TimothyWright95/Embedded-Senior-Project/Communication protocol.docx

Basestation to RCU

0 = ERROR

1 = Reached side move down

2 = Ready for Brushes

RCU to Basestation

0 = ERROR

1 = Finished moving

2 = Battery LOW

3 = End of array moved up
