TimothyWright95/Embedded-Senior-Project/PowerPoint.pptx

Modular Solar Panel Cleaner

By Timothy Wright

## Slide 2

The Problem

- Solar panels often get dirty, especially in rural farming areas
- Studies from the National Renewable Energy Laboratories show that dirty solar panels can reduce efficiency by up to 25%
- Solar panels are sometimes installed in hard to reach areas therefore it is difficult or even impossible to clean

## Slide 3

My Solution

- Modular Solar Array Cleaner or MSAC
- Autonomous robot that is installed alongside the solar array
- Robot will clean entire array according to a preset schedule using either a water or waterless system
- Modularity allows it to be fitted to almost any size solar array and is only limited by the size of the on board battery
- Also allows remote control of Robot to spot clean

## Slide 4

What currently exists

- Most solar panel cleaners are designed for commercial ground based solar arrays
- There are some solar array cleaners that are meant for home solar array such as the RAYBOT by ECOVACS and Scrobby by Stefan Hamminga
- RAYBOT- very slow and waterless only, also not currently available to buy
- Scrobby – cleans using water collected from rainfall therefore only cleans 3-4 times a year

## Slide 5

Why is MSAC Unique

- Water or waterless cleaning
- Remote control cleaning
- Battery powered with built in charger in the docking station
- Can function for a long time without human interaction
- Can follow a cleaning schedule
- Will only clean when temperature is cool enough to not damage electronics
- Modularity allows it to be fitted to most solar arrays, limited only by the size of battery on the MSAC

## Slide 6

Anticipated Problems

- Routing water to the robot
- Routing power to the x-axis motor
- Getting remote control working properly
- Getting base station communicating with robot
