TimothyWright95/Embedded-Senior-Project/PINOUT.xlsx

Microcontroller/BaseStation |  |  |  | Microcontroller/RCU |  |  |  | Battery/12v ac Adapeter
Pin | Function | Perifrial | Perifrial Pin | Pin | Function | Perifrial | Perifrial Pin | VCC connection | GND Connection
VCC | 3.3v Power | Temp/Transeiver | VCC | VCC | 3.3v Power | Transeiver | VCC | Wind | Wind
Ground | Ground | ALL | Ground | Ground | Ground | ALL | Ground | Stepper Drivers | Stepper Drivers
PA21,PA20 | GPIO | Limit Switch | Limit Switch NO Pin | PB13 | GPIO | Stepper Driver | CLK(STEP) | DC Motor | DC Motor
PB13 | GPIO | Stepper Driver | CLK(STEP) | PA21 | GPIO | Limit Switch | Limit Switch NO Pin
PB08 | ADC | Temp | Temp Data Out | PA22 | GPIO | DC Motor | DC Motor Transister Enable
PA09 | ADC | Wind | Wind Data Out | PA22 | UART | WIFI | RX
PA22 | UART | WIFI | RX | PA23 | UART | WIFI | TX
PA23 | UART | WIFI | TX
