TimothyWright95/Embedded-Senior-Project/Draft Design.png

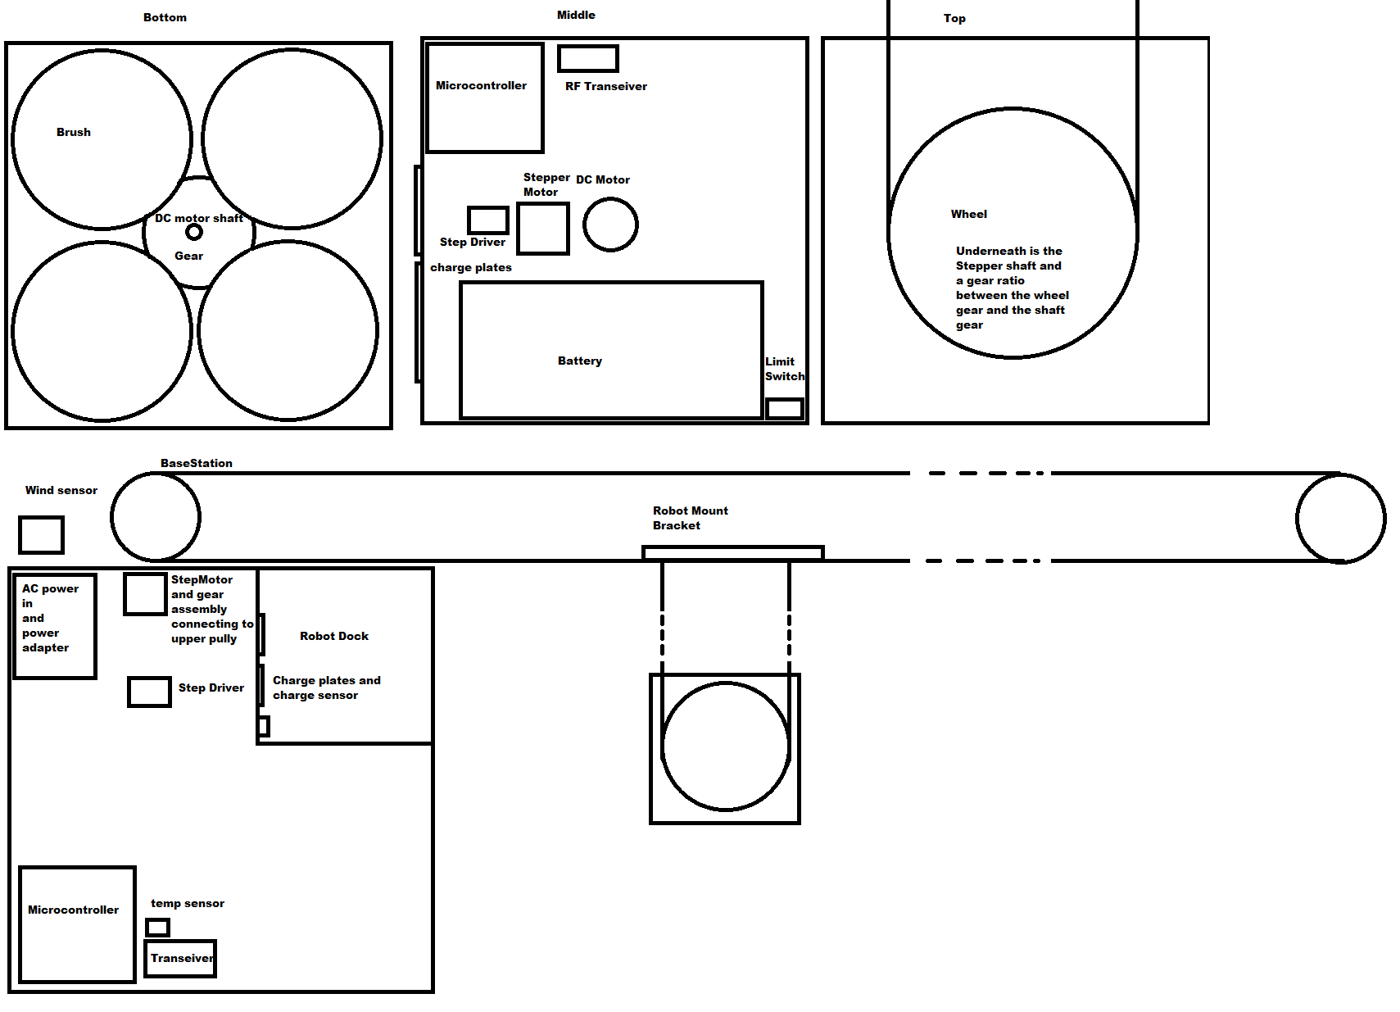
Draft Design.png
