TimothyWright95/Embedded-Senior-Project/Pully system design.png

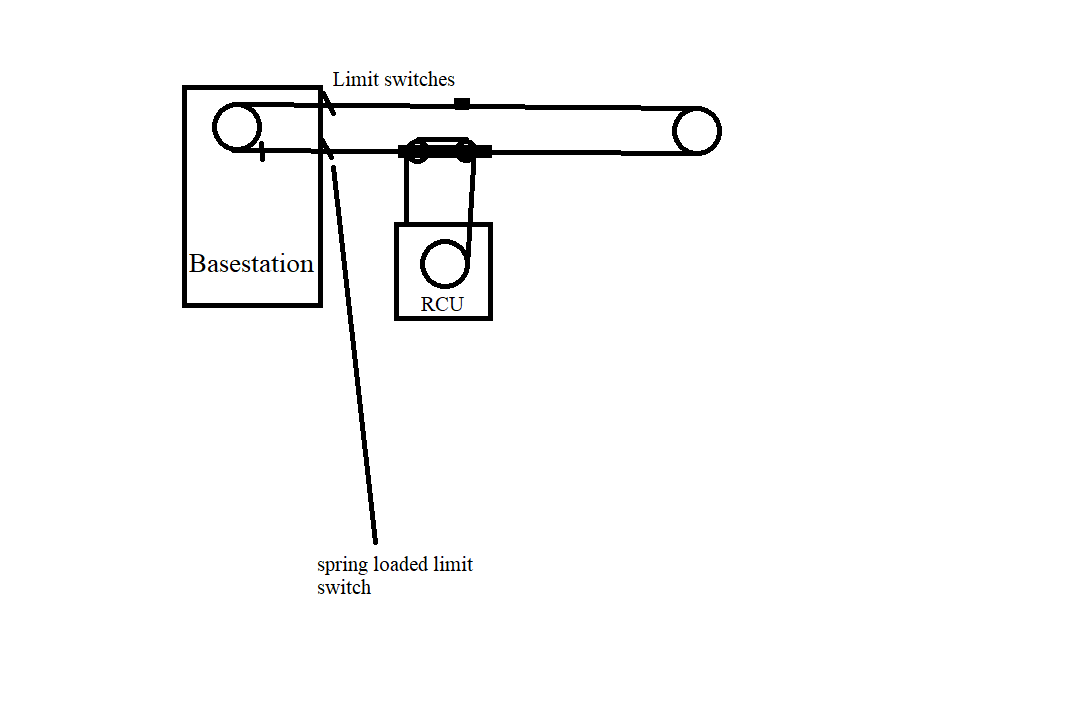
Pully system design.png
