TimothyWright95/Embedded-Senior-Project/Estimated costs.xlsx

Part | Cost | Number | Total cost
Microcontroller | $75.00 | 5 | $375.00
Limit sensor | $1.16 | 20 | $23.20
Anemometer | $44.00 | 4 | $176.00
Tempeture sensor | $1.50 | 10 | $15.00
Brush motor | $12.99 | 5 | $64.95
x/y axis motors | $48.00 | 10 | $480.00
wireless communucation | $4.00 | 10 | $40.00
Motor Driver | $10.00 | 10 | $100.00
Battery | $36.74 | 5 | $183.70
Total Parts Cost |  |  | $1457.85
Solder | $5.00 | 5 | $25.00
Flux | $5.00 | 5 | $25.00
Soldering Iron | $100.00 | 2 | $200.00
SDM3045X 4-1/2 Digit Digital Multimeter | $389.00 | 2 | $778.00
Tektronix MSO2022B Mixed Signal Oscilloscope | $3600.00 | 2 | $7200.00
SPD3303X-E Triple Output Power Supply | $389.00 | 2 | $778.00
Plywood/wood for mockup | $100.00 | 1 | $100.00
Snapmaker 2.0 A250 + Printing supplies | $2000.00 | 1 | $2000.00
Plyers/strippers/drill/etc | $1000.00 | 1 | $1000.00
steel cable(100 feet) | $100.00 | 1 | $100.00
Electrical wire(multiple sizes) | $50.00 | 1 | $50.00
Total cost of development tools |  |  | $12256.00
Cost of Engineer(Hours) | $100.00 | 600 | $60000.00
Total Cost |  |  | $73713.85
