TimothyWright95/Embedded-Senior-Project/Part Selection.xlsx

Microcontroller |  |  |  | Operating System |  |  |  | Limit sensor's x/y and charge |  |  |  | Wind sensor |  |  |  | Tempurture Sensor |  |  |  | Brush Motor |  |  |  | X/Y axis Motors |  |  |  | Wirless Communication |  |  |  | Battery |  |  |  | Stepper Motor Driver
 | ATSAM4E16E evaluation kit | Raspberry PI 4 | Arduino Mega 2560 Rev3 |  | Linux | FreeRTOS | No OS |  | V-156-1C25 | Yeeco Micro Limit Switch | CL20 |  | Adafruit Anemometer | Wind Sensor Rev. C | Build your own |  |  |  |  |  |  |  |  |  |  |  |  |  | NRF24L01+ | Hoperf RFM75 V2.0 | Solu CC1101 |  | MIGHTY MAX BATTERY 12-Volt 18 Ah | MIGHTY MAX BATTERY 12-Volt 8 Ah | MIGHTY MAX BATTERY 12-Volt 100 Ah | TB67S249FTG | TB67S249FTG Full Breakout | TB67S279FTG | TB67S249FTG Compact
Price(USD) | $75 | $35 | $38.50 | Familier | no | yes | no | type | SPDT | SPDT | SPDT | Price | $44.00 | $17.00 | UNKNOWN | robotshop SKU | B-See-351 | RB-Spa-1078 | RB-Suf-27 | robotshop SKU | RB-And-128 | RB-Dfr-670 | RB-Dfr-671 | robotshop SKU | RB-Phi-210 | RB-Phi-266 | RB-Phi-267 | Frequency | 2.4GHz | 2400-2483.5 | 387-464MHZ | Price | 36.74 | 20.36 | 174.99 | Minimum operating voltage: | 10 V | 10 V | 10 V
ADC | 4 | 0 | 16 | Real time | yes | yes | no | price per | 1.165 | 0.6495 | 0.699 | Needs Calabration | no | yes, everytime it looses power | no | Price | USD $13.90 | USD $1.50 | USD $5.99 | Price | USD $32.75 | USD $12.99 | USD $12.99 | Price | USD $44.00 | USD $74.00 | USD $48.00 | Datarate | 250kbps, 1 and 2Mbps | 250kbps, 1 and 2Mbps | up to 600 kbps | Product Depth (in.) | 3 | 2.56 | 6.61 in | Maximum operating voltage: | 47 V | 47 V | 47 V
GPIO | 13 | up to 28 | 54 | Multiple tasks at once | yes | yes | no | Amount | 6 | 20 | 10 |  |  |  |  | Brand | SeeedStudio | Sparkfun Electronics | Sunfounde | Brand | AndyMark | DFRobot | DFRobot | Brand | Phidgets | Phidgets | Phidgets | Connection type | spi | spi | spi | Product Height (in.) | 6.57 | 3.94 | 8.3 | Continuous current per phase: | 1.7 A | 1.2A | 1.6 A
PWM | 2 | 0 | 13 |  |  |  |  | DC Current rating | .6A | .6A | UNKNOWN | Input | Analog | Analog | Analog | Working voltage | 3.3V-5V | 2.7 V to 5.5 VDC | 3.3V-5V | No Load Current [A] | 2.7 | 0.17 | 0.17 | Rated Torque | 2.942 Nm | 23.5 Nm | 4.7 Nm | Price per | 1.2 | 1.9 | 6.99 | Product Width (in.) | 7.13 | 5.94 | 12.17 in | Maximum current per phase: | 4.5 A | 2A | 4.5 A
spi | 1 | up to 5 | 1 |  |  |  |  | Overall Price | 6.99 | 12.99 | 6.99 |  |  |  |  | Mesurment type | Thermister | Thermister | Thermister | Stall Current [A] | 133 | 2.19 | 2.19 |  | 416.6223 oz/in | 3333 oz/in | 667 oz/in | crystal type | ±60ppm 16MHz crystal | ±60ppm 16MHz crystal | UNKNOWN | Battery Capacity (mAh) | 18000 | 8000 | 100000 | Minimum logic voltage: | 2V | 2V | 2V
FreeRTOS | yes | no | no |  |  |  |  |  |  |  |  |  |  |  |  | Temperature measurement range | -50 to +600°C | −40°C to +125°C | UNKOWN | No Load RPM | 5310 | 100 | 50 | Nominal Current [A] | 1.7 | 2.8 | 1.7 | voltage | 1.9-3.6 (5v tollerant on chip voltage regulator) | 1.9-3.6 | 1.8-3.6 | Battery Power Type | Sealed Lead Acid | Sealed Lead Acid | Sealed Lead Acid | Maximum logic voltage: | 5.5 V | 5.5 V | 5.5 V
 |  |  |  |  |  |  |  |  |  |  |  |  |  |  |  |  |  |  |  | Rated RPM | 4614 | 93 | 45 | Height | 0 mm | 57 mm | 57 mm | Docs | Good | Good | Poor | Battery Size | 12-volt | 12-volt | 12-volt | Microstep resolutions: | full, non-circular 1/2, 1/2, 1/4, 1/8, 1/16, 1/32 | full, non-circular 1/2, 1/2, 1/4, 1/8, 1/16, 1/32 | full, non-circular 1/2, 1/2, 1/4, 1/8, 1/16, 1/32
 |  |  |  |  |  |  |  |  |  |  |  |  |  |  |  | Selected |  | X |  | Output Shaft Diameter [mm] | 7.9502 mm | 6 mm | 6 mm |  | 0 in | 2.2441 in | 2.2441 in |  |  |  |  | Brand Name | MIGHTY MAX BATTERY | MIGHTY MAX BATTERY | MIGHTY MAX BATTERY | Current limit control: | potentiometer | potentiometer | potentiometer
Selected | X |  |  | Selected |  | X |  | Slected | X |  |  | Selected | X |  |  |  |  |  |  |  | 0.313 in | 0.2362 in | 0.2362 in | Length | 0 mm | 128 mm | 87.7 mm | Selected | X |  |  | Cell Type | Specialty | Specialty | Specialty | Reverse voltage protection?: | Y | Y | N
 |  |  |  |  |  |  |  |  |  |  |  |  |  |  |  |  |  |  |  | Output Shaft Length | 31.623 mm | 15 mm | 15 mm |  | 0 in | 5.0394 in | 3.4528 in |  |  |  |  | Discharge Cycle | Deep Cycle | Deep Cycle | Deep Cycle | Header pins soldered?: | N | N | N
Reason | Can run FreeRTOS and has all inputs needed |  |  | Reason | Developer is familier with this OS and OS does not matter as long as it can run multiple tasks at once |  |  | Reason | Lowest price with know current limit |  |  | Reason | Does not need calibration, no need to construct my own, only premade anemometer avaliable |  |  | Reason | Price |  |  |  | 1.245 in | 0.5906 in | 0.5906 in | Nominal Voltage [V] | 12 | 12 | 12 | Reason | The NRF24L01+ was chosen due to it meeting all the neededrequirments and having the cheepest price. The NRF24L01+ is also the one with the most supporting documentation and is a popular RF transeiver used in the embedded systems community. |  |  | Features | Rechargeable | Rechargeable | Rechargeable | Price | 11.95 | 9.75 | 9.95
 |  |  |  |  |  |  |  |  |  |  |  |  |  |  |  |  |  |  |  | Rated Torque | 0.3178 Nm | 0.6865 Nm | 0.8826 Nm | Weight | 503 g | 1496.8536 g | 564 g |  |  |  |  | Number in Package | 1 | 1 | 1
 |  |  |  |  |  |  |  |  |  |  |  |  |  |  |  |  |  |  |  |  | 45.0043 oz/in | 97.2166 oz/in | 124.9867 oz/in |  | 1.1089 lb | 3.3 lb | 1.2434 lb |  |  |  |  | Returnable | 90-Day | 90-Day | 90-Day | Selected | X
 |  |  |  |  |  |  |  |  |  |  |  |  |  |  |  |  |  |  |  | Stall Torque | 2.4249 Nm | 4.1188 Nm | 4.9033 Nm |  | 17.605 oz | 52.3899 oz | 19.74 oz |  |  |  |  | SLA Type | Absorbent Glass Mat (AGM) | Absorbent Glass Mat (AGM) | Absorbent Glass Mat (AGM)
 |  |  |  |  |  |  |  |  |  |  |  |  |  |  |  |  |  |  |  |  | 343.3948 oz/in | 583.2712 oz/in | 694.3658 oz/in | Width | 0 mm | 57 mm | 57 mm |  |  |  |  | Safety & Security Product Type | Battery | Battery | Battery | Reason | The TB67S249FTG was chosen because its max current per phase matched the max current of the stepper motor that was chosen, the compact version will not work because the continuous current was only 1.6A and not 1.7A because of this same reason the 279 was not chosen since it can only output 1.2A
 |  |  |  |  |  |  |  |  |  |  |  |  |  |  |  |  |  |  |  | Height | 63.5 mm | 37 mm | 37 mm |  | 0 in | 2.2441 in | 2.2441 in
 |  |  |  |  |  |  |  |  |  |  |  |  |  |  |  |  |  |  |  |  | 2.5 in | 1.4567 in | 1.4567 in | No. of Leads | 4 | 4 | 4 |  |  |  |  | Selected | X
 |  |  |  |  |  |  |  |  |  |  |  |  |  |  |  |  |  |  |  | Length | 110.236 mm | 58 mm | 58 mm | Resolution
 |  |  |  |  |  |  |  |  |  |  |  |  |  |  |  |  |  |  |  |  | 4.34 in | 2.2835 in | 2.2835 in | Type | Bipolar | Bipolar | Bipolar |  |  |  |  | Reason | The mighty max 12v battery was chosen because the motors that were chosen use 12v. The 18Ah battery was chosen over the 100 Ah because the price for the 100 AH was to much as well as the battery was to large. The 18 Ah battery was chosen over the 8Ah battery because the cost per Ah was less and a larger battery will allow the system to run longer without charging since there will be a 12v motor constantly running off the battery.
 |  |  |  |  |  |  |  |  |  |  |  |  |  |  |  |  |  |  |  | Nominal Voltage [V] | 12 | 12 | 12
 |  |  |  |  |  |  |  |  |  |  |  |  |  |  |  |  |  |  |  |  |  |  |  | Selected |  |  | X
 |  |  |  |  |  |  |  |  |  |  |  |  |  |  |  |  |  |  |  | Selected |  | X
 |  |  |  |  |  |  |  |  |  |  |  |  |  |  |  |  |  |  |  | Reason | The RB-Dfr-670 was chosen because it outputs the desired rotations per minute as well as having a low cost. Depending on the final weight of the robot a different motot may be chosen that has a higher torque. |  |  | Reason
