TimothyWright95/Embedded-Senior-Project/3D Printing/Hex center x=6.5mm 10mm test.stl

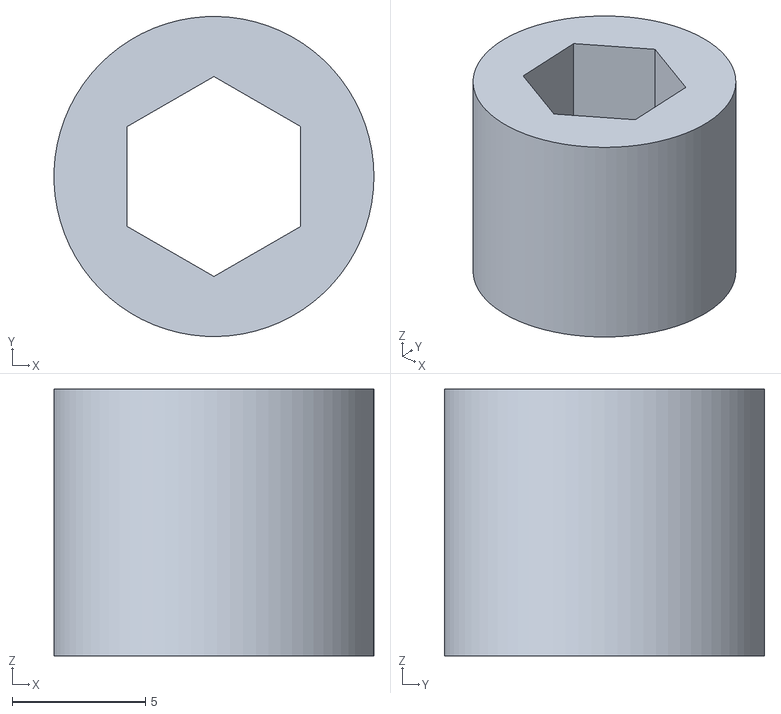
[picture p34: CAD file, 2021-08-05]
3D Printing/Hex center x=6.5mm 10mm test.stl
12.0 x 12.0 x 10.0
