TimothyWright95/Embedded-Senior-Project/3D Printing/DC motor Shaft Gear Large.stl

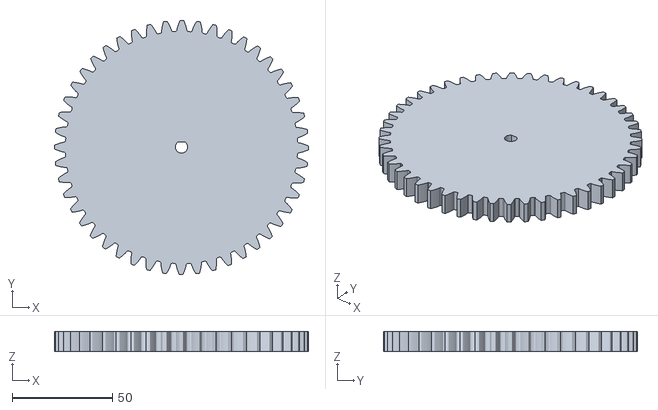
[picture p35: CAD file, 2021-08-05]
3D Printing/DC motor Shaft Gear Large.stl
127.0 x 127.0 x 10.0
