TimothyWright95/Embedded-Senior-Project/3D Printing/PullyTest no gear.stl

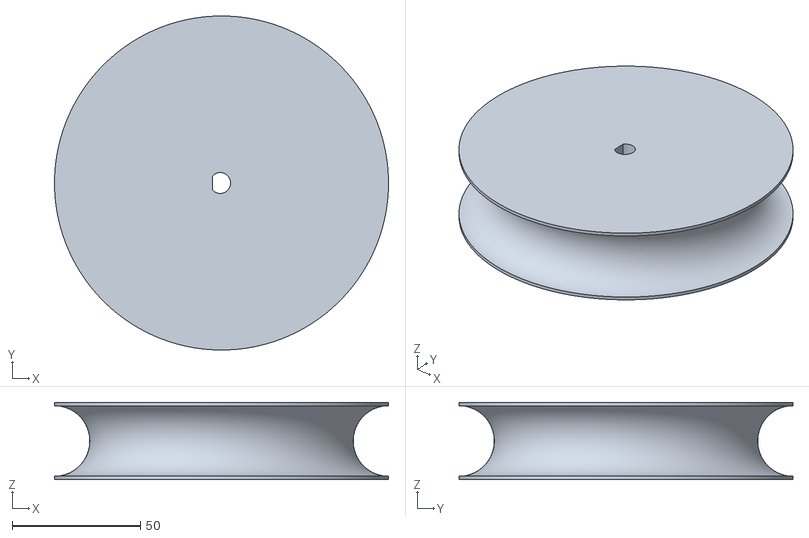
[picture p36: CAD file, 2021-08-05]
3D Printing/PullyTest no gear.stl
130.0 x 130.0 x 30.0
