TimothyWright95/Embedded-Senior-Project/3D Printing/pully shaft testt.stl

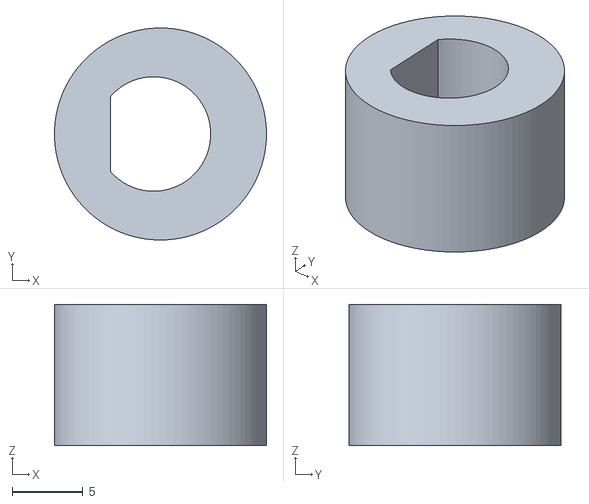
[picture p37: CAD file, 2021-08-05]
3D Printing/pully shaft testt.stl
15.0 x 15.0 x 10.0
