TimothyWright95/Embedded-Senior-Project/3D Printing/DC motor Shaft Test.stl

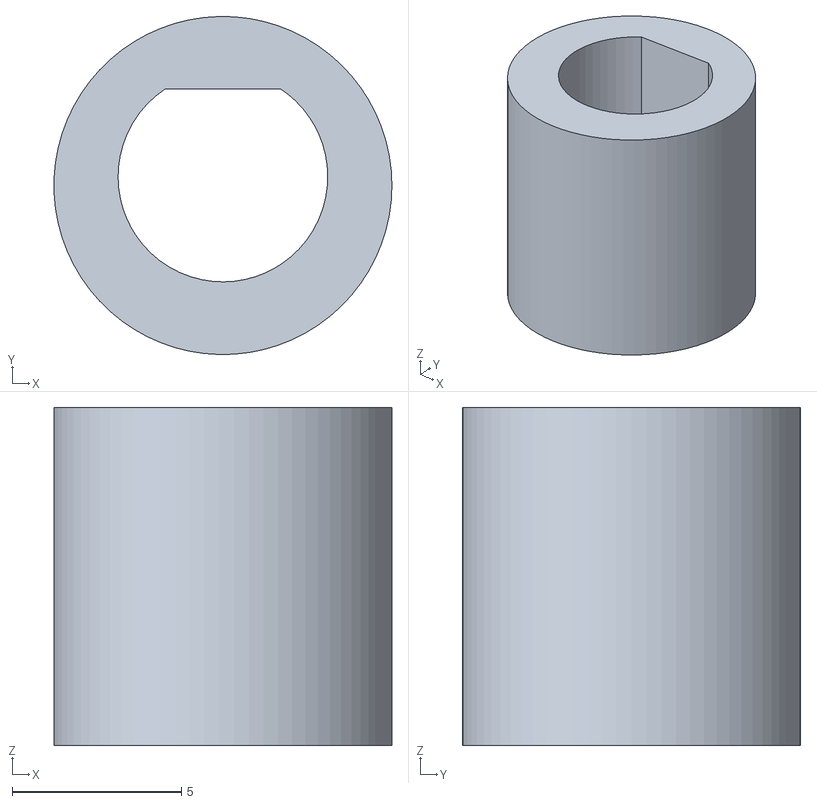
[picture p38: CAD file, 2021-08-05]
3D Printing/DC motor Shaft Test.stl
9.99 x 10.00 x 10.0
