TimothyWright95/Embedded-Senior-Project/3D Printing/DC motor Shaft gear.stl

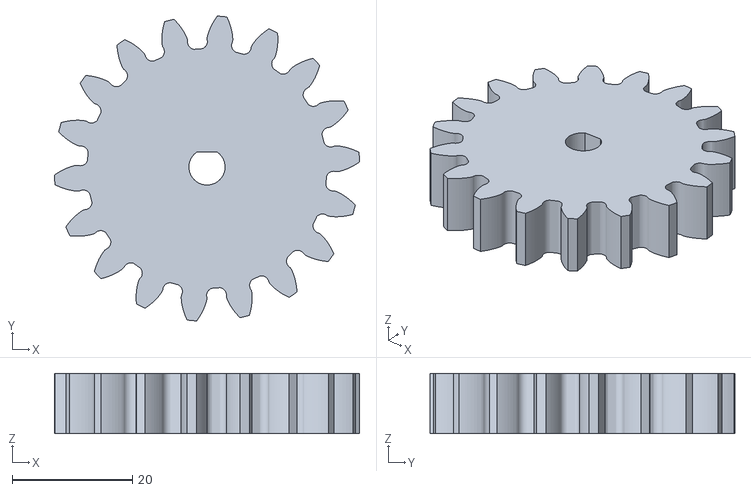
[picture p39: CAD file, 2021-08-05]
3D Printing/DC motor Shaft gear.stl
50.8 x 50.7 x 10.0
