TimothyWright95/Embedded-Senior-Project/3D Printing/coupler test.stl

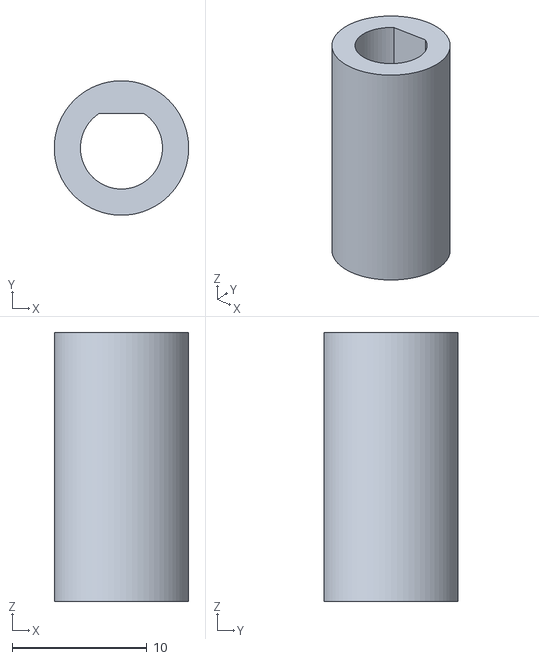
[picture p40: CAD file, 2021-08-05]
3D Printing/coupler test.stl
10.00 x 10.00 x 20.0
