TimothyWright95/Embedded-Senior-Project/(list of files, cad)

Other CAD files:
3D Printing/Brush Gear Hex center Final.stl
3D Printing/Brush Hex center Motor Transition Gear.stl
