TimothyWright95/Embedded-Senior-Project/Test Plan and Results template 2020.xlsx

Test Plan and Result Template
Project Name |  |  |  | Overall comments: Most requirements can be verified by watching the demo video
Company Name
Engineer
Test Plan Date and update dates
Requirement Number | Requirement Description | Percent Complete | Test methodology | Test Equipment | Special test condition | Test Disposition | Test Date | Test Trial No. | Associated test document | Test Notes
Requirement Number from requirements doc. | Requirement description from requirements document is listed here. If there are sub requirements list them as well. Some requirements have sub requirements. List the sub requirements as well. If a requirement has multiple tests, then add a new row for that test. | List pct complete | How was this requirement tested? Press ALT+ENTER for new line in Excel | List any test equipment used for the test | List any special conditions for your test | PASS, FAIL, PARTIAL PASS | List the planned date or run | List number of test attempts | List associated test documents here by file name indicating proof of successful test. Place the documents into the same folder as this template | List any notes
1 | The system shall use two microcontroller | 100% | Looked at parts | NONE | NONE | PASS | June 3rd, 2020 | 1 | CST473_Final_Presentation | Verifiable by viewing the video demo Timestamp: 21:36 and 23:06
2 | The two microcontrollers shall communicate with wireless technology capable of transmitting at a rate of 1kbps over a distance of 65 feet | 50% | Will position devices 65 feet apart and transmit a 10kb file timing while transmitting, if the total time to transfer is less than 10 second then the test passes | Wireless transmitters | Must transmit 10kb file in less then 10 sec at a distance of 65 feet | PARTIAL PASS | June 3rd, 2020 | 1 | https://arunoda.me/blog/load-testing-an-esp8266 | The devices are capable of transmitting at this rate and can be demonstrated using a laptop and manually typing in the setrcu or setbs URL's, however the WIFI modules disconnect from the AP after every transmision. If a sufficiently large transmition was sent the transfer rate would be able to overcome this however, as memory on the device is limited this wasn't possible therefore a partial pass was given. The given web link shows extensive testing done on the ESP8266 showing its possible transfer speed. Although the transfer speeds of M.S.A.C didn't reach this due to the client disconnecting after every transmission, this shows that the devices are capable of 1kbps.
3 | The system shall consist of a base station, a robot, a website and a controler | 100% | Looked at parts and software | Basestation, RCU, Website host, computer to connect to website, controller | NONE | PASS | June 3rd, 2020 | 1 | CST473_Final_Presentation WEBSITE_SCREENSHOT.jpg | Verifiable by viewing the video demo Timestamp: 21:25, 23:00, 25:23 Basestation, Robot, Controller respectivly. Website can be seen on the included screenshot
4 | The robot shall be powered by a battery capable of running the robot for at least 2 hours under normal operation. | 100% | Will put to robot into max power usage mode and measure the current draw. Then using the current draw and the max amperage of the battery, calculate the max time the robot can run at max power. | Ionic Battery Manager, RCU | Amperage of the battery divided by the max current draw of the system must exceed 2hours | PASS | June 3rd, 2020 | 1 | Battery_AMP.jpg | As can be seen in the Ionic Battery Manager screenshot the RCU at max load only draws .5 amps and with the battery at 98% capasity that will last more than 27 hours. More than 10 times the requirment. (probably could use a smaller battery)
5 | The base station shall be powered by 120 v at 60 Hz converted down to meet system requirements | 100% | Connect power supply to board and verify power is being supplier | NONE | NONE | PASS | June 3rd, 2020 | 1 | CST473_Final_Presentation | Can be verified due to the fact that the Basestation is powered in the demo. Timestamp: 21:25
6 | The base station shall provide a way to charge the robot when docked | 100% | Dock RCU and verify the barery is charging | Ammeter, Basestation, RCU | Current must be flowing from the charger into the RCU battery | PASS | June 3rd, 2020 | 1 | CST473_Final_Presentation | Timestamp: 22:27
7 | If the robot’s battery is running under 20% the system shall pause the cleaning, dock the robot, wait for the robot to recharge then resume cleaning | 100% | Either drain the battery or do a software trigger to trigger the low battery state. After this verify robot docks and charges then continues to clean the array where it stoped. | RCU, Basestation, Ammeter,Mockup array | RCU must dock and charge battery, then return to where it left off | PASS | June 3rd, 2020 | 1 | Battery Level Circuit CST473_Final_Presentation | As can be seen in the wind and temperature code for requirment 28 and 29 we can read in the voltage value of the battery using the Battery Level Circuit design. As can be seen in the calculation a 1.1v reading indicates 12.1 volts, which is slightly higher than 20% remaining battery. As can be seen in the demonstration at timestamp: 22:27, the robot would touch the copper plates resulting in the batter charging. (curently its disconected due to the broken terminal)
8 | The base station shall control the x-axis movement of the robot | 100% | Verify visually the Basestation controlls the x-axis movement | RCU, Basestation,Mockup array | NONE | PASS | June 3rd, 2020 | 1 | CST473_Final_Presentation | Can be seen throughout the demo that the Basestation controlls the x axis pully
9 | The robot shall control the y-axis movement of the robot | 100% | Verify visually the RCU controlls the Y-axis movement | RCU,Mockup array | NONE | PASS | June 3rd, 2020 | 1 | CST473_Final_Presentation | Can be seen throughout the demo that the RCU controlls the y axis pully
10 | The robot shall clean the solar panels using a brush at a rate of .1 inches per second. | 100% | Measure the time it takes for the RCU to cover a 1 foot in less then 2 minutes | RCU, Basestation, Mockup array |  | PASS | June 3rd, 2020 | 1 | CST473_Final_Presentation | Can be seen throughout the demo that the x axis movement is much faster that .1in/sec Calculations are as follows: 1 step = 0.018 degrees, device is set for 1/4 step. Therefore each pulse is 0.0045 degrees. Basestation micro runs at 4mhz. Divider is 444 resulting in a pulse of 9009hz or 9009 quarter steps per second. 1 revolution takes 360/0.0045 pulses = 80,000 pulses The circumfrance of the pully is 13 in. at 9009 pulses/second one revolution takes 80,000 / 9009 s = 8.88 seconds therefor in 8.8 seconds the rcu moves 13in or 1.46 in/sec; way higher than the required 0.1 in/sec
11 | The system shall provide a way to swap between manual and autonomous mode | 100% | Verify the manual switch on the controller puts MSAC in manual mode | Controller, Mockup array, Basestation, RCU | NONE | PASS | June 3rd, 2020 | 1 | CST473_Final_Presentation | Timestamp: 26:10
12 | The system shall include a controller that can control the robot. | 100% | Verify controller exists and that it can control the RCU | Controller, Mockup array, Basestation, RCU | NONE | PASS | June 3rd, 2020 | 1 | CST473_Final_Presentation | Timestamp: 26:10-32:00
13 | The controller shall provide a way to control the x and y axis movement of the robot | 100% | Verify controller exists and that it can control the x and y movement | Controller, Mockup array, Basestation, RCU | NONE | PASS | June 3rd, 2020 | 1 | CST473_Final_Presentation | Can be verified during the manual mode demo Timestamp: 26:10-32:00
14 | The controller shall provide a way to turn on and off the cleaning brush | 100% | Verify controller exists and that it can turn on and off the brushes | Controller, Mockup array, Basestation, RCU | NONE | PASS | June 3rd, 2020 | 1 | CST473_Final_Presentation | Timestamp: 29:50
15 | The controller shall provide a way to automatically dock the robot. | 100% | Verify controller exists and that it can automatically dock the RCU | Controller, Mockup array, Basestation, RCU | NONE | PASS | June 3rd, 2020 | 1 | CST473_Final_Presentation | Can be seen when manual mode is disabled. This feature was rolled into the disabling of manual mode. By disabling manual mode the robot automatically docks. This is essentially the same as requirment 16.
16 | The system shall automatically dock the robot if the user did not dock the robot in manual mode and has swapped into autonomous mode | 100% | Verify that when swapping back to autonomous mode the RCU docks into the Basestation | Controller, Mockup array, Basestation, RCU | NONE | PASS | June 3rd, 2020 | 1 | CST473_Final_Presentation | Can be seen when manual mode is disabled. By disabling manual mode the robot automatically docks. This is essentially the same as requirment 15. Timestamp: 30:35
17 | The system shall have the ability to follow a schedule based on the time of day and day of week | 0% | Verify that a time slot set by the user on the web page will trigger a cleaning by setting the Basestation time to 5 minutes before the selected time slot and verifying the cleaning starts. | Mockup array, Basestation, RCU, Website, Computer to access website | NONE | FAIL | May 25th, 2020 | 0 | Not completed | Not completed
18 | The system shall provide a way for the user to set the schedule | 100% | Verify the website allows the user to select time slots to start a cleaning and verify those selected time slots are getting stored on the Basestation | Website, computer, Basestation | NONE | PASS | June 3rd, 2020 | 1 | WEBSITE_SCREENSHOT.jpg | Schedual setting can be seen in the website screenshot
19 | The system shall provide a way to initiate a cleaning outside the set schedule | 100% | Verify that a button on the controller starts an autonomous cleaning | Controller, Mockup array, Basestation, RCU | NONE | PASS | June 3rd, 2020 | 1 | CST473_Final_Presentation | Timestamp:32:05
20 | The system shall include a temperature and wind sensor | 100% | Verify the temperature and wind sensor exists and that the correct values are being read by the Basestation | Wind sensor, temp sensor, Basestation, computer | NONE | PASS | June 3rd, 2020 | 1 | CST473_Final_Presentation | Timestamp: 24:33
21 | The system shall postpone cleaning if the outside temperature is above 80 degrees | 100% | Modify the return value of the temp function to return a value higher than the threashold. Verify a schedualed on unscheduled cleaning does not start. | Controler Mockup array, Basestation, RCU | NONE | PASS | June 3rd, 2020 | 1 | Sensor Read tempwind.mp4 | Verified the cleaning didn’t start when the button was pressed. Due to having to modify the code to test this it wasn’t part of the demo. However as can be seen in the tempwind video we can determine the wind and temperature and using the code in sensor read we return a different value if the sensor reading is above the threashold
22 | The system shall postpone cleaning if the speed of the wind is above 10m.s | 100% | Modify the return value of the temp function to return a value higher than the threashold. Verify a schedualed on unscheduled cleaning does not start. | Controler Mockup array, Basestation, RCU | NONE | PASS | June 3rd, 2020 | 1 | Sensor Read tempwind.mp4 | Verified the cleaning didn’t start when the button was pressed. Due to having to modify the code to test this it wasn’t part of the demo. However as can be seen in the tempwind video we can determine the wind and temperature and using the code in sensor read we return a different value if the sensor reading is above the threashold
23 | The system shall clean the solar panels by traversing left to right or right to left from top to bottom | 100% | Verify the RCU cleans the solar panels in the required fasion by recording a cleaning and verifying it did not deviate from said fasion | Controler Mockup array, Basestation, RCU | NONE | PASS | June 3rd, 2020 | 1 | CST473_Final_Presentation | Viewable during the autonomous cleaning timestamp: 32:05
