TimothyWright95/Embedded-Senior-Project/(list of files, drawings)

Other design files:
PCB/BaseStationPCB.dip
PCB/BaseStationScematic.dch
PCB/RCUPCB.dip
PCB/RCUScematic.dch
