TimothyWright95/Embedded-Senior-Project/Board Code/BASESTATION BACK/MyProject/Device_Startup/startup_samc21.c

/**
 * \file
 *
 * \brief gcc starttup file for SAMC21
 *
 * Copyright (c) 2018 Microchip Technology Inc.
 *
 * \asf_license_start
 *
 * \page License
 *
 * SPDX-License-Identifier: Apache-2.0
 *
 * Licensed under the Apache License, Version 2.0 (the "License"); you may
 * not use this file except in compliance with the License.
 * You may obtain a copy of the Licence at
 * 
 * http://www.apache.org/licenses/LICENSE-2.0
 * 
 * Unless required by applicable law or agreed to in writing, software
 * distributed under the License is distributed on an AS IS BASIS, WITHOUT
 * WARRANTIES OR CONDITIONS OF ANY KIND, either express or implied.
 * See the License for the specific language governing permissions and
 * limitations under the License.
 *
 * \asf_license_stop
 *
 */

#include "samc21.h"

/* Initialize segments */
extern uint32_t _sfixed;
extern uint32_t _efixed;
extern uint32_t _etext;
extern uint32_t _srelocate;
extern uint32_t _erelocate;
extern uint32_t _szero;
extern uint32_t _ezero;
extern uint32_t _sstack;
extern uint32_t _estack;

/** \cond DOXYGEN_SHOULD_SKIP_THIS */
int main(void);
/** \endcond */

void __libc_init_array(void);

/* Default empty handler */
void Dummy_Handler(void);

/* Cortex-M0+ core handlers */
void NonMaskableInt_Handler  ( void ) __attribute__ ((weak, alias("Dummy_Handler")));
void HardFault_Handler       ( void ) __attribute__ ((weak, alias("Dummy_Handler")));
void SVCall_Handler          ( void ) __attribute__ ((weak, alias("Dummy_Handler")));
void PendSV_Handler          ( void ) __attribute__ ((weak, alias("Dummy_Handler")));
void SysTick_Handler         ( void ) __attribute__ ((weak, alias("Dummy_Handler")));

/* Peripherals handlers */
void SYSTEM_Handler          ( void ) __attribute__ ((weak, alias("Dummy_Handler"))); /* MCLK, OSC32KCTRL, OSCCTRL, PAC, PM, SUPC, TAL */
void WDT_Handler             ( void ) __attribute__ ((weak, alias("Dummy_Handler")));
void RTC_Handler             ( void ) __attribute__ ((weak, alias("Dummy_Handler")));
void EIC_Handler             ( void ) __attribute__ ((weak, alias("Dummy_Handler")));
void FREQM_Handler           ( void ) __attribute__ ((weak, alias("Dummy_Handler")));
#ifdef ID_TSENS
void TSENS_Handler           ( void ) __attribute__ ((weak, alias("Dummy_Handler")));
#endif
void NVMCTRL_Handler         ( void ) __attribute__ ((weak, alias("Dummy_Handler")));
void DMAC_Handler            ( void ) __attribute__ ((weak, alias("Dummy_Handler")));
void EVSYS_Handler           ( void ) __attribute__ ((weak, alias("Dummy_Handler")));
void SERCOM0_Handler         ( void ) __attribute__ ((weak, alias("Dummy_Handler")));
void SERCOM1_Handler         ( void ) __attribute__ ((weak, alias("Dummy_Handler")));
void SERCOM2_Handler         ( void ) __attribute__ ((weak, alias("Dummy_Handler")));
void SERCOM3_Handler         ( void ) __attribute__ ((weak, alias("Dummy_Handler")));
#ifdef ID_SERCOM4
void SERCOM4_Handler         ( void ) __attribute__ ((weak, alias("Dummy_Handler")));
#endif
#ifdef ID_SERCOM5
void SERCOM5_Handler         ( void ) __attribute__ ((weak, alias("Dummy_Handler")));
#endif
#ifdef ID_CAN0
void CAN0_Handler            ( void ) __attribute__ ((weak, alias("Dummy_Handler")));
#endif
#ifdef ID_CAN1
void CAN1_Handler            ( void ) __attribute__ ((weak, alias("Dummy_Handler")));
#endif
void TCC0_Handler            ( void ) __attribute__ ((weak, alias("Dummy_Handler")));
#ifdef ID_TCC1
void TCC1_Handler            ( void ) __attribute__ ((weak, alias("Dummy_Handler")));
#endif
#ifdef ID_TCC2
void TCC2_Handler            ( void ) __attribute__ ((weak, alias("Dummy_Handler")));
#endif
void TC0_Handler             ( void ) __attribute__ ((weak, alias("Dummy_Handler")));
void TC1_Handler             ( void ) __attribute__ ((weak, alias("Dummy_Handler")));
void TC2_Handler             ( void ) __attribute__ ((weak, alias("Dummy_Handler")));
void TC3_Handler             ( void ) __attribute__ ((weak, alias("Dummy_Handler")));
void TC4_Handler             ( void ) __attribute__ ((weak, alias("Dummy_Handler")));
#ifdef ID_ADC0
void ADC0_Handler            ( void ) __attribute__ ((weak, alias("Dummy_Handler")));
#endif
#ifdef ID_ADC1
void ADC1_Handler            ( void ) __attribute__ ((weak, alias("Dummy_Handler")));
#endif
#ifdef ID_AC
void AC_Handler              ( void ) __attribute__ ((weak, alias("Dummy_Handler")));
#endif
#ifdef ID_DAC
void DAC_Handler             ( void ) __attribute__ ((weak, alias("Dummy_Handler")));
#endif
#ifdef ID_SDADC
void SDADC_Handler           ( void ) __attribute__ ((weak, alias("Dummy_Handler")));
#endif
#ifdef ID_PTC
void PTC_Handler             ( void ) __attribute__ ((weak, alias("Dummy_Handler")));
#endif

/* Exception Table */
__attribute__ ((section(".vectors")))
const DeviceVectors exception_table = {

        /* Configure Initial Stack Pointer, using linker-generated symbols */
        .pvStack                = (void*) (&_estack),

        .pfnReset_Handler       = (void*) Reset_Handler,
        .pfnNonMaskableInt_Handler = (void*) NonMaskableInt_Handler,
        .pfnHardFault_Handler   = (void*) HardFault_Handler,
        .pvReservedM12          = (void*) (0UL), /* Reserved */
        .pvReservedM11          = (void*) (0UL), /* Reserved */
        .pvReservedM10          = (void*) (0UL), /* Reserved */
        .pvReservedM9           = (void*) (0UL), /* Reserved */
        .pvReservedM8           = (void*) (0UL), /* Reserved */
        .pvReservedM7           = (void*) (0UL), /* Reserved */
        .pvReservedM6           = (void*) (0UL), /* Reserved */
        .pfnSVCall_Handler      = (void*) SVCall_Handler,
        .pvReservedM4           = (void*) (0UL), /* Reserved */
        .pvReservedM3           = (void*) (0UL), /* Reserved */
        .pfnPendSV_Handler      = (void*) PendSV_Handler,
        .pfnSysTick_Handler     = (void*) SysTick_Handler,

        /* Configurable interrupts */
        .pfnSYSTEM_Handler      = (void*) SYSTEM_Handler,         /*  0 Main Clock, 32k Oscillators Control, Oscillators Control, Peripheral Access Controller, Power Manager, Supply Controller, Trigger Allocator */
        .pfnWDT_Handler         = (void*) WDT_Handler,            /*  1 Watchdog Timer */
        .pfnRTC_Handler         = (void*) RTC_Handler,            /*  2 Real-Time Counter */
        .pfnEIC_Handler         = (void*) EIC_Handler,            /*  3 External Interrupt Controller */
        .pfnFREQM_Handler       = (void*) FREQM_Handler,          /*  4 Frequency Meter */
#ifdef ID_TSENS
        .pfnTSENS_Handler       = (void*) TSENS_Handler,          /*  5 Temperature Sensor */
#else
        .pvReserved5            = (void*) (0UL),                  /*  5 Reserved */
#endif
        .pfnNVMCTRL_Handler     = (void*) NVMCTRL_Handler,        /*  6 Non-Volatile Memory Controller */
        .pfnDMAC_Handler        = (void*) DMAC_Handler,           /*  7 Direct Memory Access Controller */
        .pfnEVSYS_Handler       = (void*) EVSYS_Handler,          /*  8 Event System Interface */
        .pfnSERCOM0_Handler     = (void*) SERCOM0_Handler,        /*  9 Serial Communication Interface 0 */
        .pfnSERCOM1_Handler     = (void*) SERCOM1_Handler,        /* 10 Serial Communication Interface 1 */
        .pfnSERCOM2_Handler     = (void*) SERCOM2_Handler,        /* 11 Serial Communication Interface 2 */
        .pfnSERCOM3_Handler     = (void*) SERCOM3_Handler,        /* 12 Serial Communication Interface 3 */
#ifdef ID_SERCOM4
        .pfnSERCOM4_Handler     = (void*) SERCOM4_Handler,        /* 13 Serial Communication Interface 4 */
#else
        .pvReserved13           = (void*) (0UL),                  /* 13 Reserved */
#endif
#ifdef ID_SERCOM5
        .pfnSERCOM5_Handler     = (void*) SERCOM5_Handler,        /* 14 Serial Communication Interface 5 */
#else
        .pvReserved14           = (void*) (0UL),                  /* 14 Reserved */
#endif
#ifdef ID_CAN0
        .pfnCAN0_Handler        = (void*) CAN0_Handler,           /* 15 Control Area Network 0 */
#else
        .pvReserved15           = (void*) (0UL),                  /* 15 Reserved */
#endif
#ifdef ID_CAN1
        .pfnCAN1_Handler        = (void*) CAN1_Handler,           /* 16 Control Area Network 1 */
#else
        .pvReserved16           = (void*) (0UL),                  /* 16 Reserved */
#endif
        .pfnTCC0_Handler        = (void*) TCC0_Handler,           /* 17 Timer Counter Control 0 */
#ifdef ID_TCC1
        .pfnTCC1_Handler        = (void*) TCC1_Handler,           /* 18 Timer Counter Control 1 */
#else
        .pvReserved18           = (void*) (0UL),                  /* 18 Reserved */
#endif
#ifdef ID_TCC2
        .pfnTCC2_Handler        = (void*) TCC2_Handler,           /* 19 Timer Counter Control 2 */
#else
        .pvReserved19           = (void*) (0UL),                  /* 19 Reserved */
#endif
        .pfnTC0_Handler         = (void*) TC0_Handler,            /* 20 Basic Timer Counter 0 */
        .pfnTC1_Handler         = (void*) TC1_Handler,            /* 21 Basic Timer Counter 1 */
        .pfnTC2_Handler         = (void*) TC2_Handler,            /* 22 Basic Timer Counter 2 */
        .pfnTC3_Handler         = (void*) TC3_Handler,            /* 23 Basic Timer Counter 3 */
        .pfnTC4_Handler         = (void*) TC4_Handler,            /* 24 Basic Timer Counter 4 */
#ifdef ID_ADC0
        .pfnADC0_Handler        = (void*) ADC0_Handler,           /* 25 Analog Digital Converter 0 */
#else
        .pvReserved25           = (void*) (0UL),                  /* 25 Reserved */
#endif
#ifdef ID_ADC1
        .pfnADC1_Handler        = (void*) ADC1_Handler,           /* 26 Analog Digital Converter 1 */
#else
        .pvReserved26           = (void*) (0UL),                  /* 26 Reserved */
#endif
#ifdef ID_AC
        .pfnAC_Handler          = (void*) AC_Handler,             /* 27 Analog Comparators */
#else
        .pvReserved27           = (void*) (0UL),                  /* 27 Reserved */
#endif
#ifdef ID_DAC
        .pfnDAC_Handler         = (void*) DAC_Handler,            /* 28 Digital Analog Converter */
#else
        .pvReserved28           = (void*) (0UL),                  /* 28 Reserved */
#endif
#ifdef ID_SDADC
        .pfnSDADC_Handler       = (void*) SDADC_Handler,          /* 29 Sigma-Delta Analog Digital Converter */
#else
        .pvReserved29           = (void*) (0UL),                  /* 29 Reserved */
#endif
#ifdef ID_PTC
        .pfnPTC_Handler         = (void*) PTC_Handler             /* 30 Peripheral Touch Controller */
#else
        .pvReserved30           = (void*) (0UL)                   /* 30 Reserved */
#endif
};

/**
 * \brief This is the code that gets called on processor reset.
 * To initialize the device, and call the main() routine.
 */
void Reset_Handler(void)
{
        uint32_t *pSrc, *pDest;

        /* Initialize the relocate segment */
        pSrc = &_etext;
        pDest = &_srelocate;

        if (pSrc != pDest) {
                for (; pDest < &_erelocate;) {
                        *pDest++ = *pSrc++;
                }
        }

        /* Clear the zero segment */
        for (pDest = &_szero; pDest < &_ezero;) {
                *pDest++ = 0;
        }

        /* Set the vector table base address */
        pSrc = (uint32_t *) & _sfixed;
        SCB->VTOR = ((uint32_t) pSrc & SCB_VTOR_TBLOFF_Msk);

        /* Initialize the C library */
        __libc_init_array();

        /* Branch to main function */
        main();

        /* Infinite loop */
        while (1);
}

/**
 * \brief Default interrupt handler for unused IRQs.
 */
void Dummy_Handler(void)
{
        while (1) {
        }
}
